georgesleen/microcouple/3d-model/microcouple.step

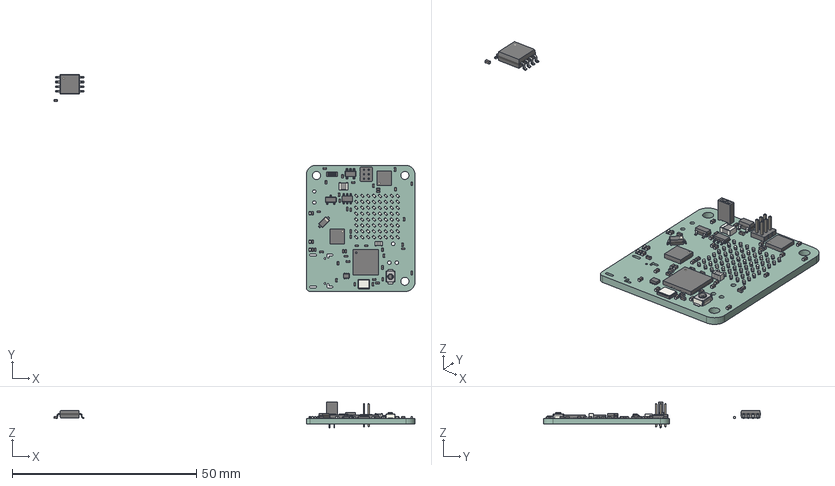
[picture p1: CAD file, 2025-11-13]
3d-model/microcouple.step
98.0 x 58.9 x 7.00 mm
LED_0402_1005Metric x 67
SW_SPST_B3U-1000P
C_0402_1005Metric x 43
L_1008_2520Metric
TSOT-23-6
SOT-23-5
SOT-23
QFN-32-1EP_4x4mm_P0.4mm_EP2.65x2.65mm
QFN-24-1EP_4x4mm_P0.5mm_EP2.6x2.6mm
QFN-56-1EP_7x7mm_P0.4mm_EP3.2x3.2mm
L_0805_2012Metric
PinHeader_2x03_P1.27mm_Vertical
SOIC-8_5.3x5.3mm_P1.27mm
SOT-666
PinSocket_2x01_P1.27mm_Vertical
Crystal_SMD_3225-4Pin_3.2x2.5mm
D_SOD-123
microcouple_PCB
