georgesleen/microcouple/drawings/microcouple-schematic-drawing.pdf/microcouple.pdf

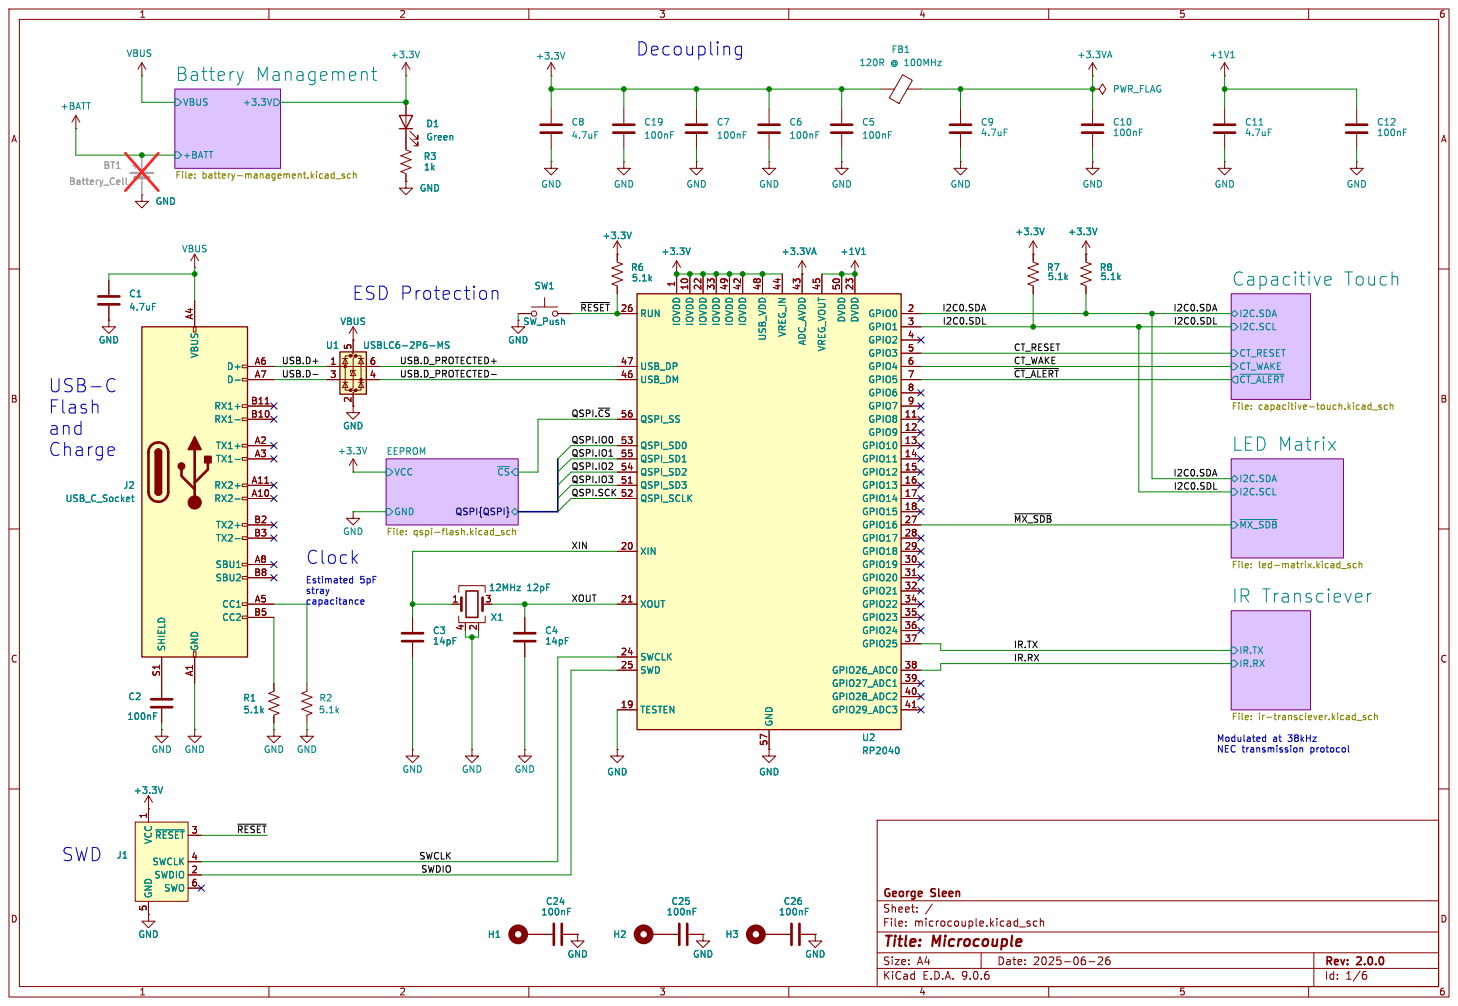
[picture p2: page 1]

+BATT Battery Management File: battery-management.kicad_sch

100nF GND
~{RESET} QSPI.IO0 QSPI.IO1 SWDIO

1 IOVDD 10 IOVDD 22 IOVDD 33 IOVDD 49 IOVDD 42 USB_VDD 48 GND 57 VREG_IN 44 ADC_AVDD 43 VREG_VOUT 45 DVDD 50 DVDD 23 GPIO0 2 GPIO1 3 GPIO2 4 GPIO3 5 GPIO4 6 GPIO5 7 GPIO6 8 GPIO7 9 GPIO8 11 GPIO9 12 GPIO10 13 GPIO11 14 GPIO12 15 GPIO13 16 GPIO14 17 GPIO15 18 GPIO16 27 GPIO17 28 GPIO18 29 GPIO19 30 GPIO20 31 GPIO21 32 GPIO22 34 GPIO23 35 GPIO24 36 GPIO25 37 GPIO26_ADC0 38 GPIO27_ADC1 39 GPIO28_ADC2 40 GPIO29_ADC3 41 U2 RP2040

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

I2C0.SDL QSPI.IO3 QSPI.IO2 XOUT

IR.TX USB.D+ USB.D-

5 ~{RESET}3 SWCLK 4 SWDIO 2 SWO 6 GND

5 ~{RESET}3 SWCLK 4 SWDIO 2 SWO 6

File: microcouple.kicad_sch Sheet: / George Sleen

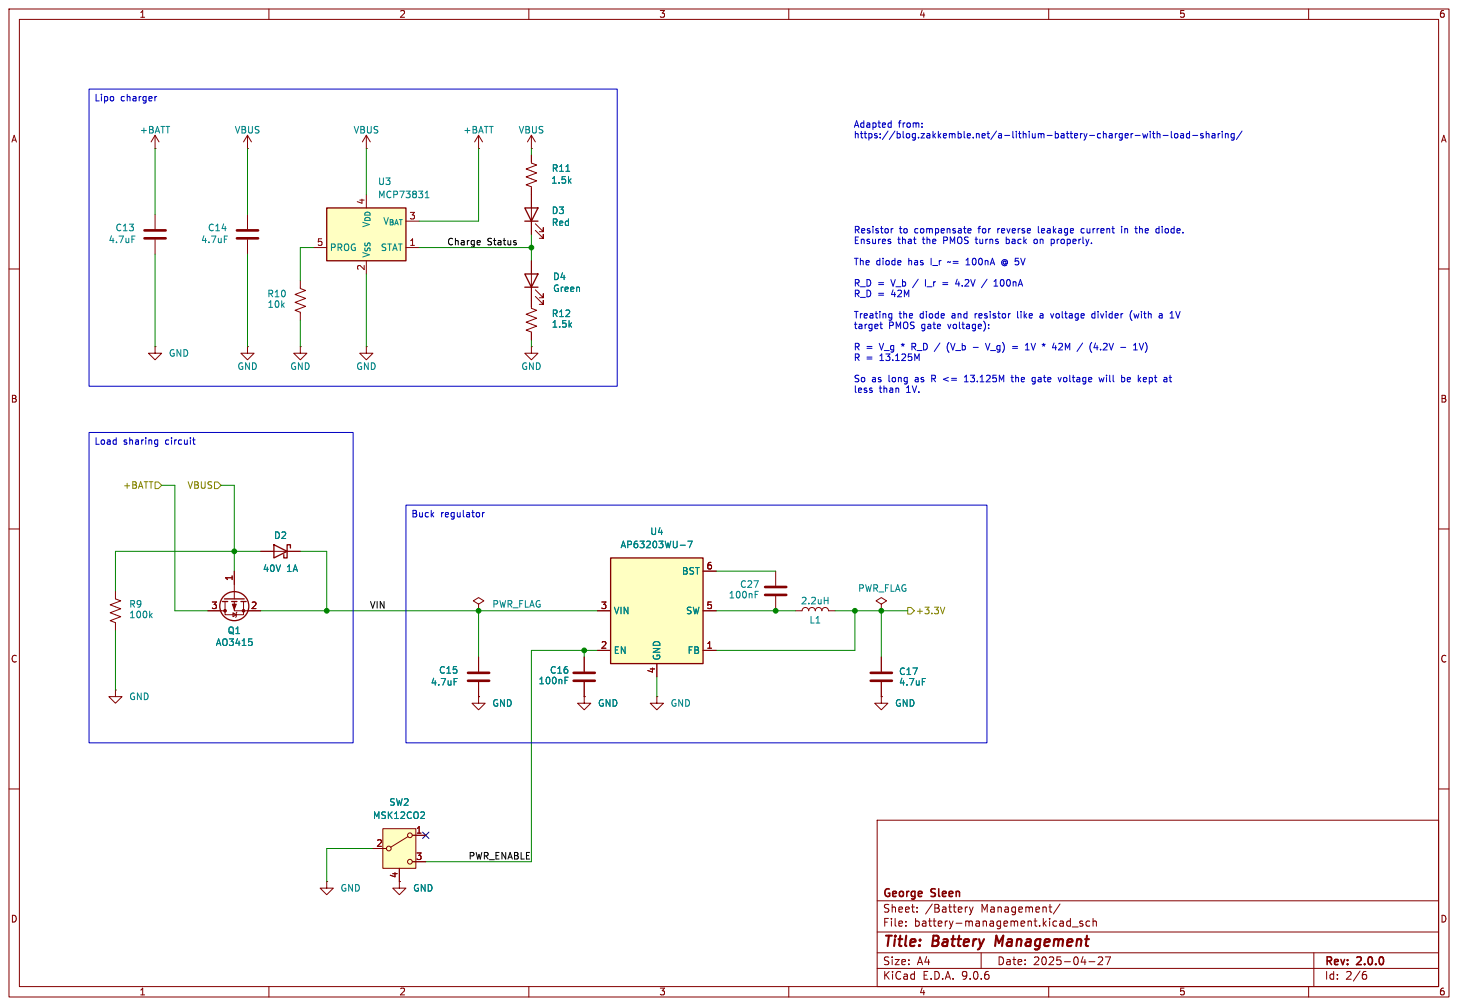
[picture p3: page 2]

Adapted from: https://blog.zakkemble.net/a-lithium-battery-charger-with-load-sharing/

target PMOS gate voltage): R = V_g * R_D / (V_b - V_g) = 1V * 42M / (4.2V - 1V) R = 13.125M
less than 1V. C17

So as long as R <= 13.125M the gate voltage will be kept at

4 BST 6 SW 5 FB 1 U4 AP63203WU-7 GND GND GND

4 BST 6 SW 5 FB 1 GND GND

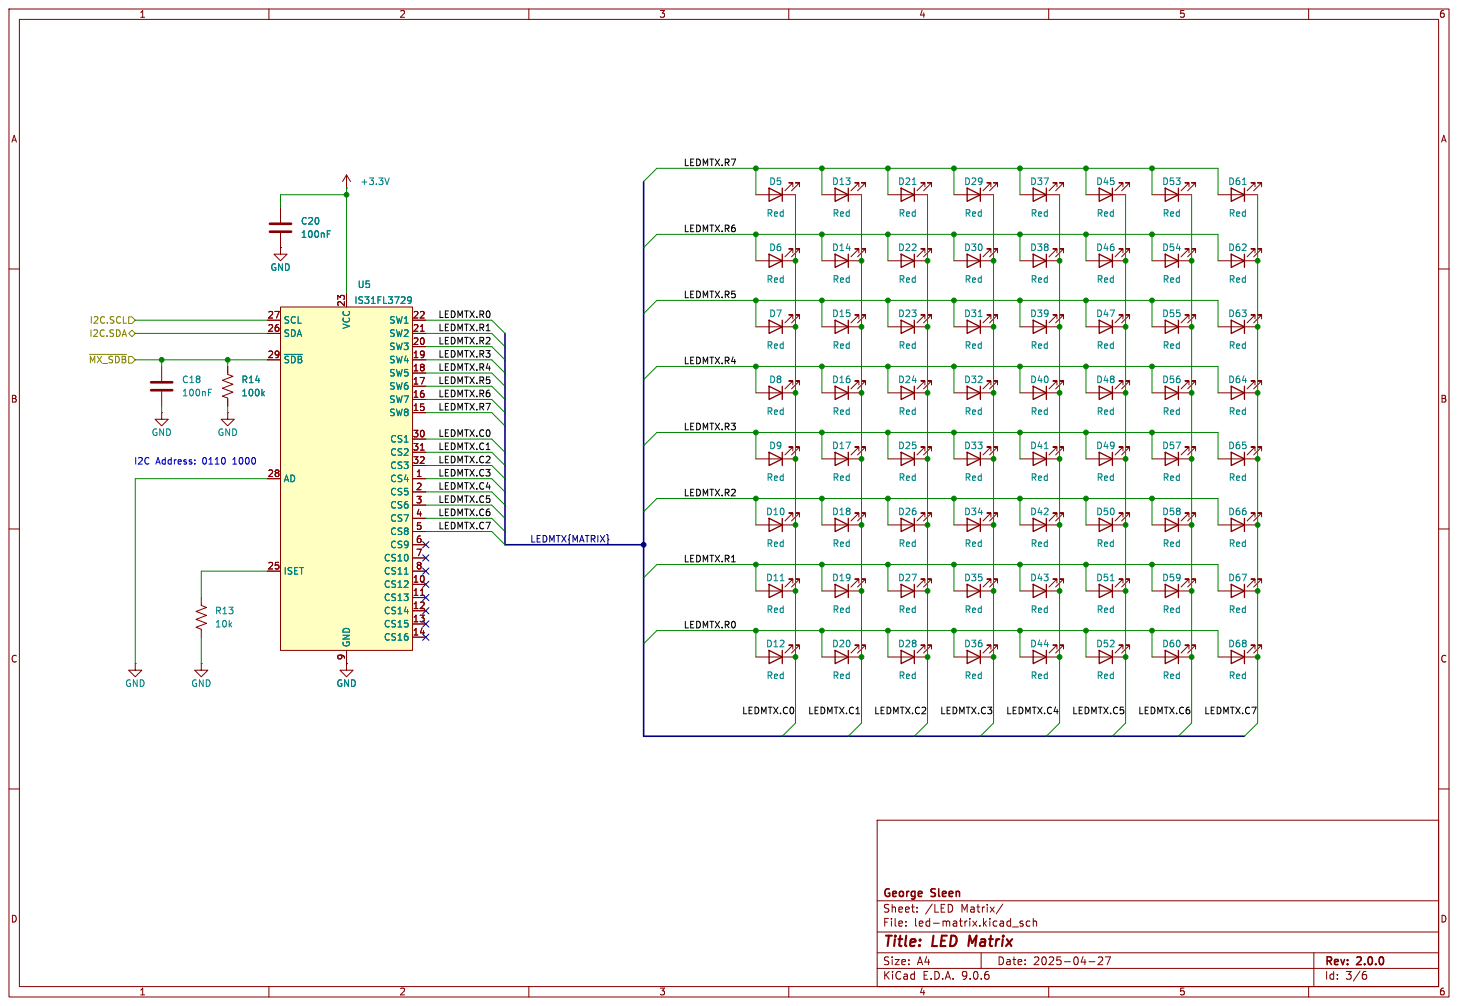
[picture p4: page 3]

D48 Red D21 Red D20 Red GND

Id: 3/6 Title: LED Matrix

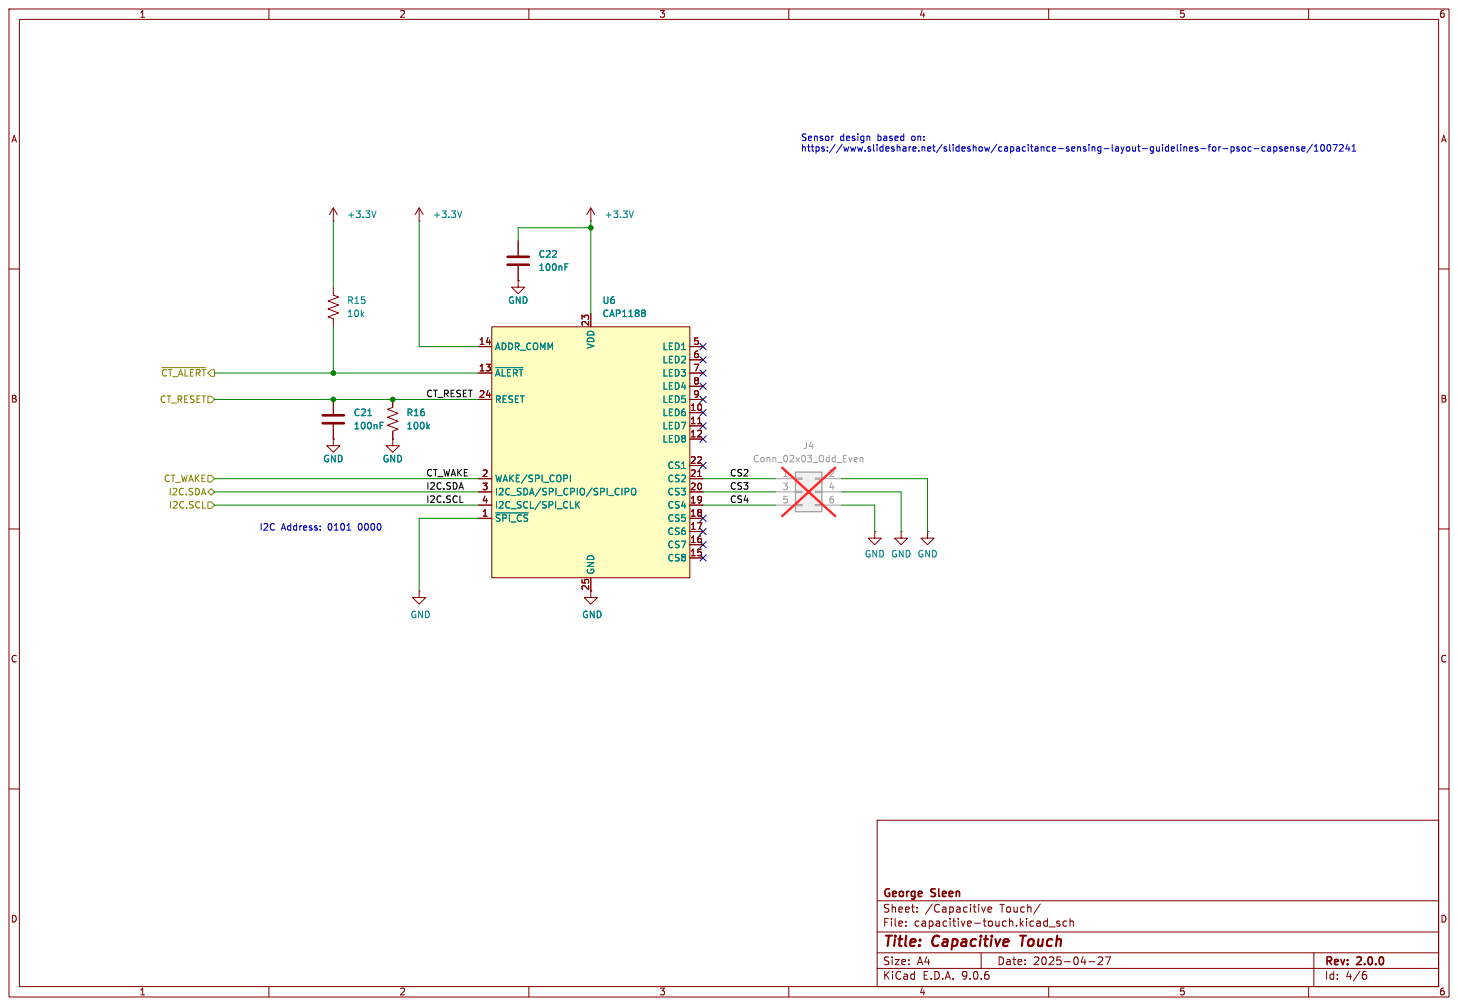
[picture p5: page 4]

Id: 4/6 Title: Capacitive Touch

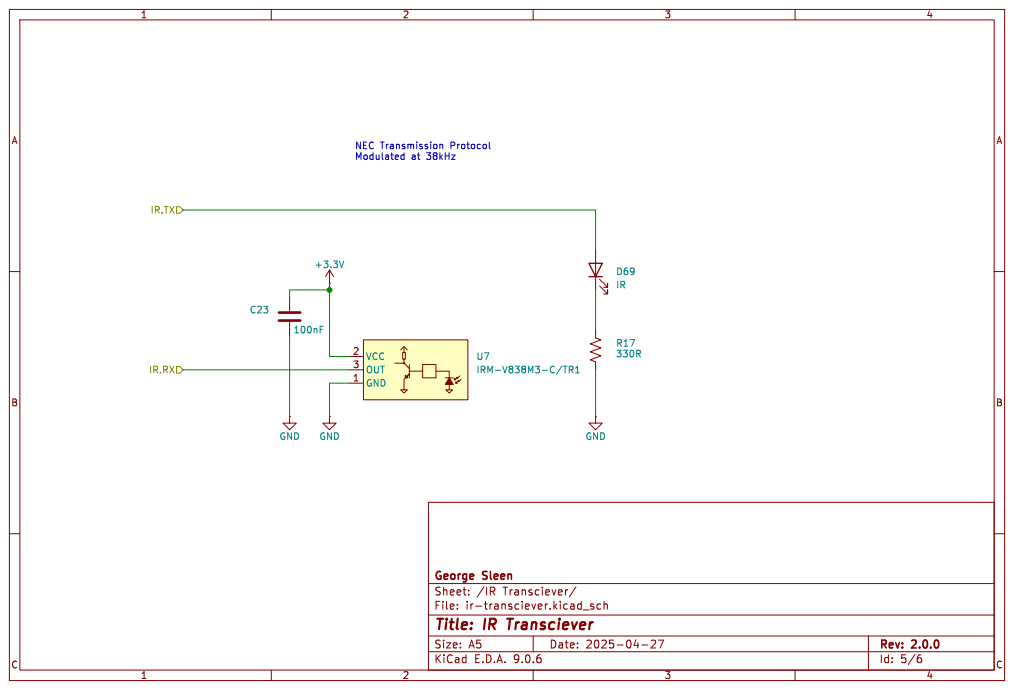
[picture p6: page 5]

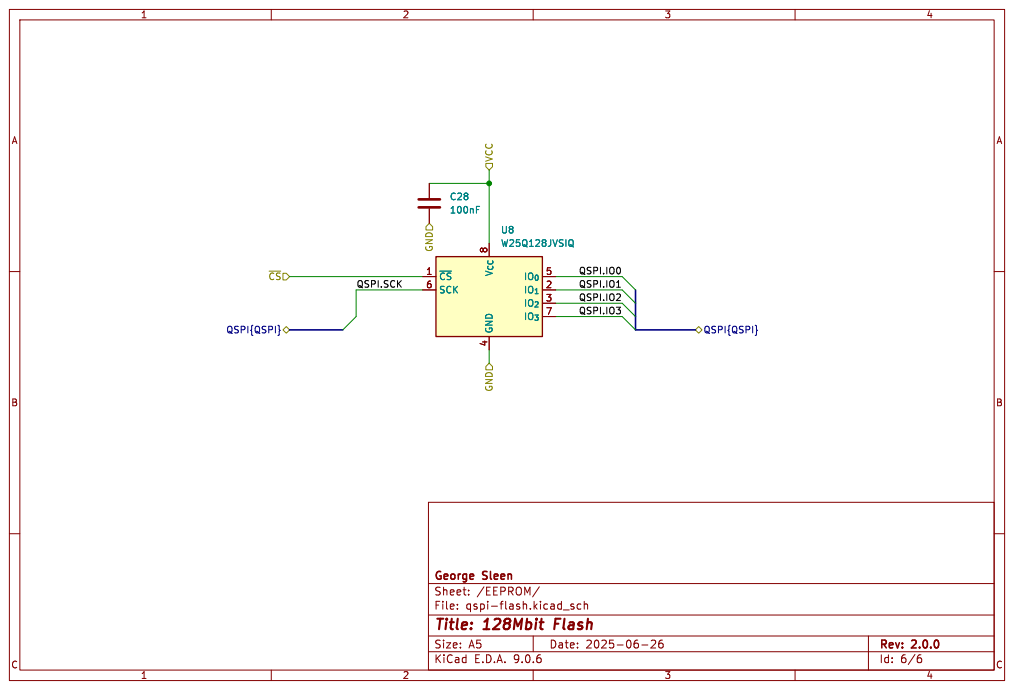
[picture p7: page 6]

File: qspi-flash.kicad_sch Sheet: /EEPROM/ George Sleen
