georgesleen/microcouple/drawings/microcouple-front-pcb-drawing.pdf/microcouple.pdf

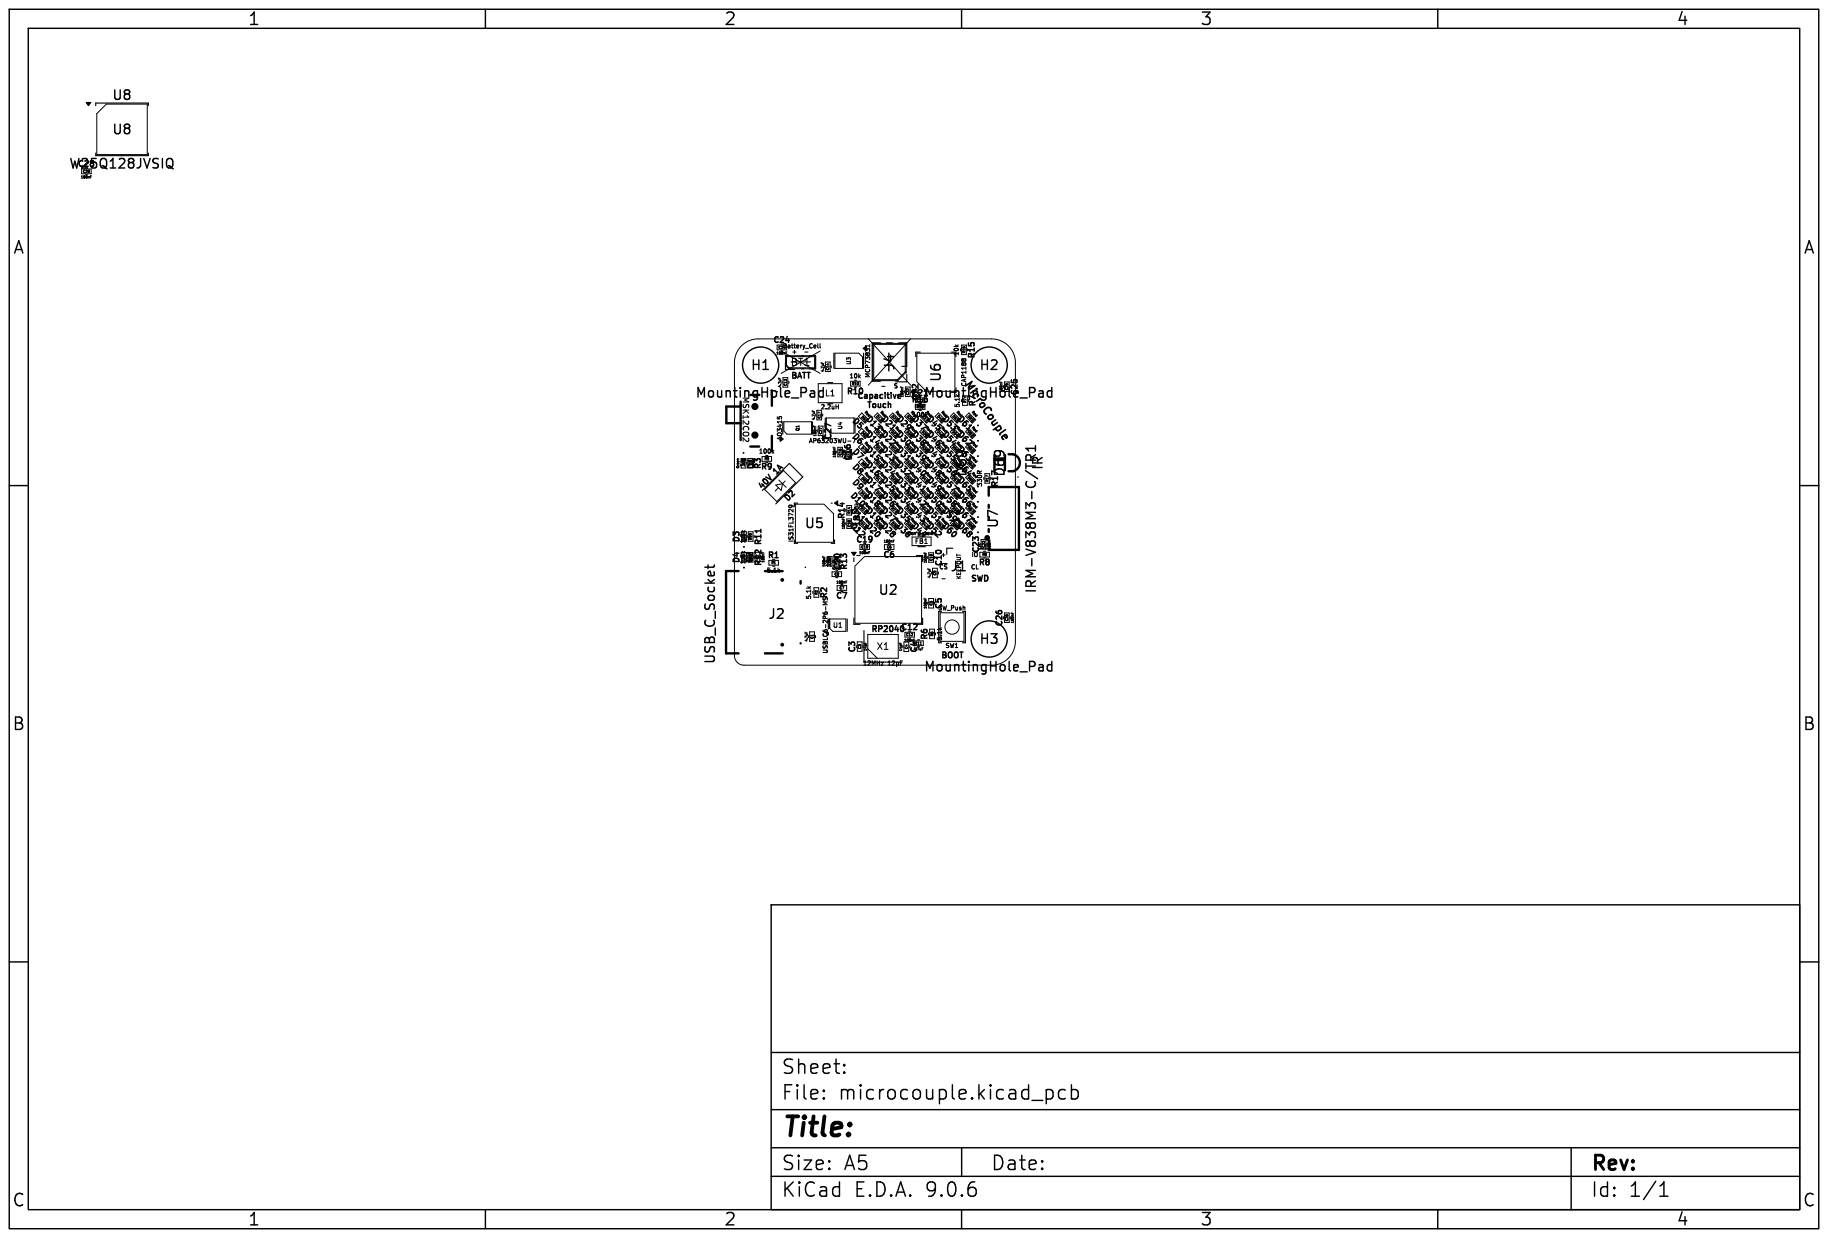
[picture p8: page 1]

Id: 1/1 Title: File: microcouple.kicad_pcb Sheet:
