georgesleen/microcouple/pcb/microcouple.kicad_pcb

## KiCad design pcb/microcouple.kicad_pcb (2025-06-26)

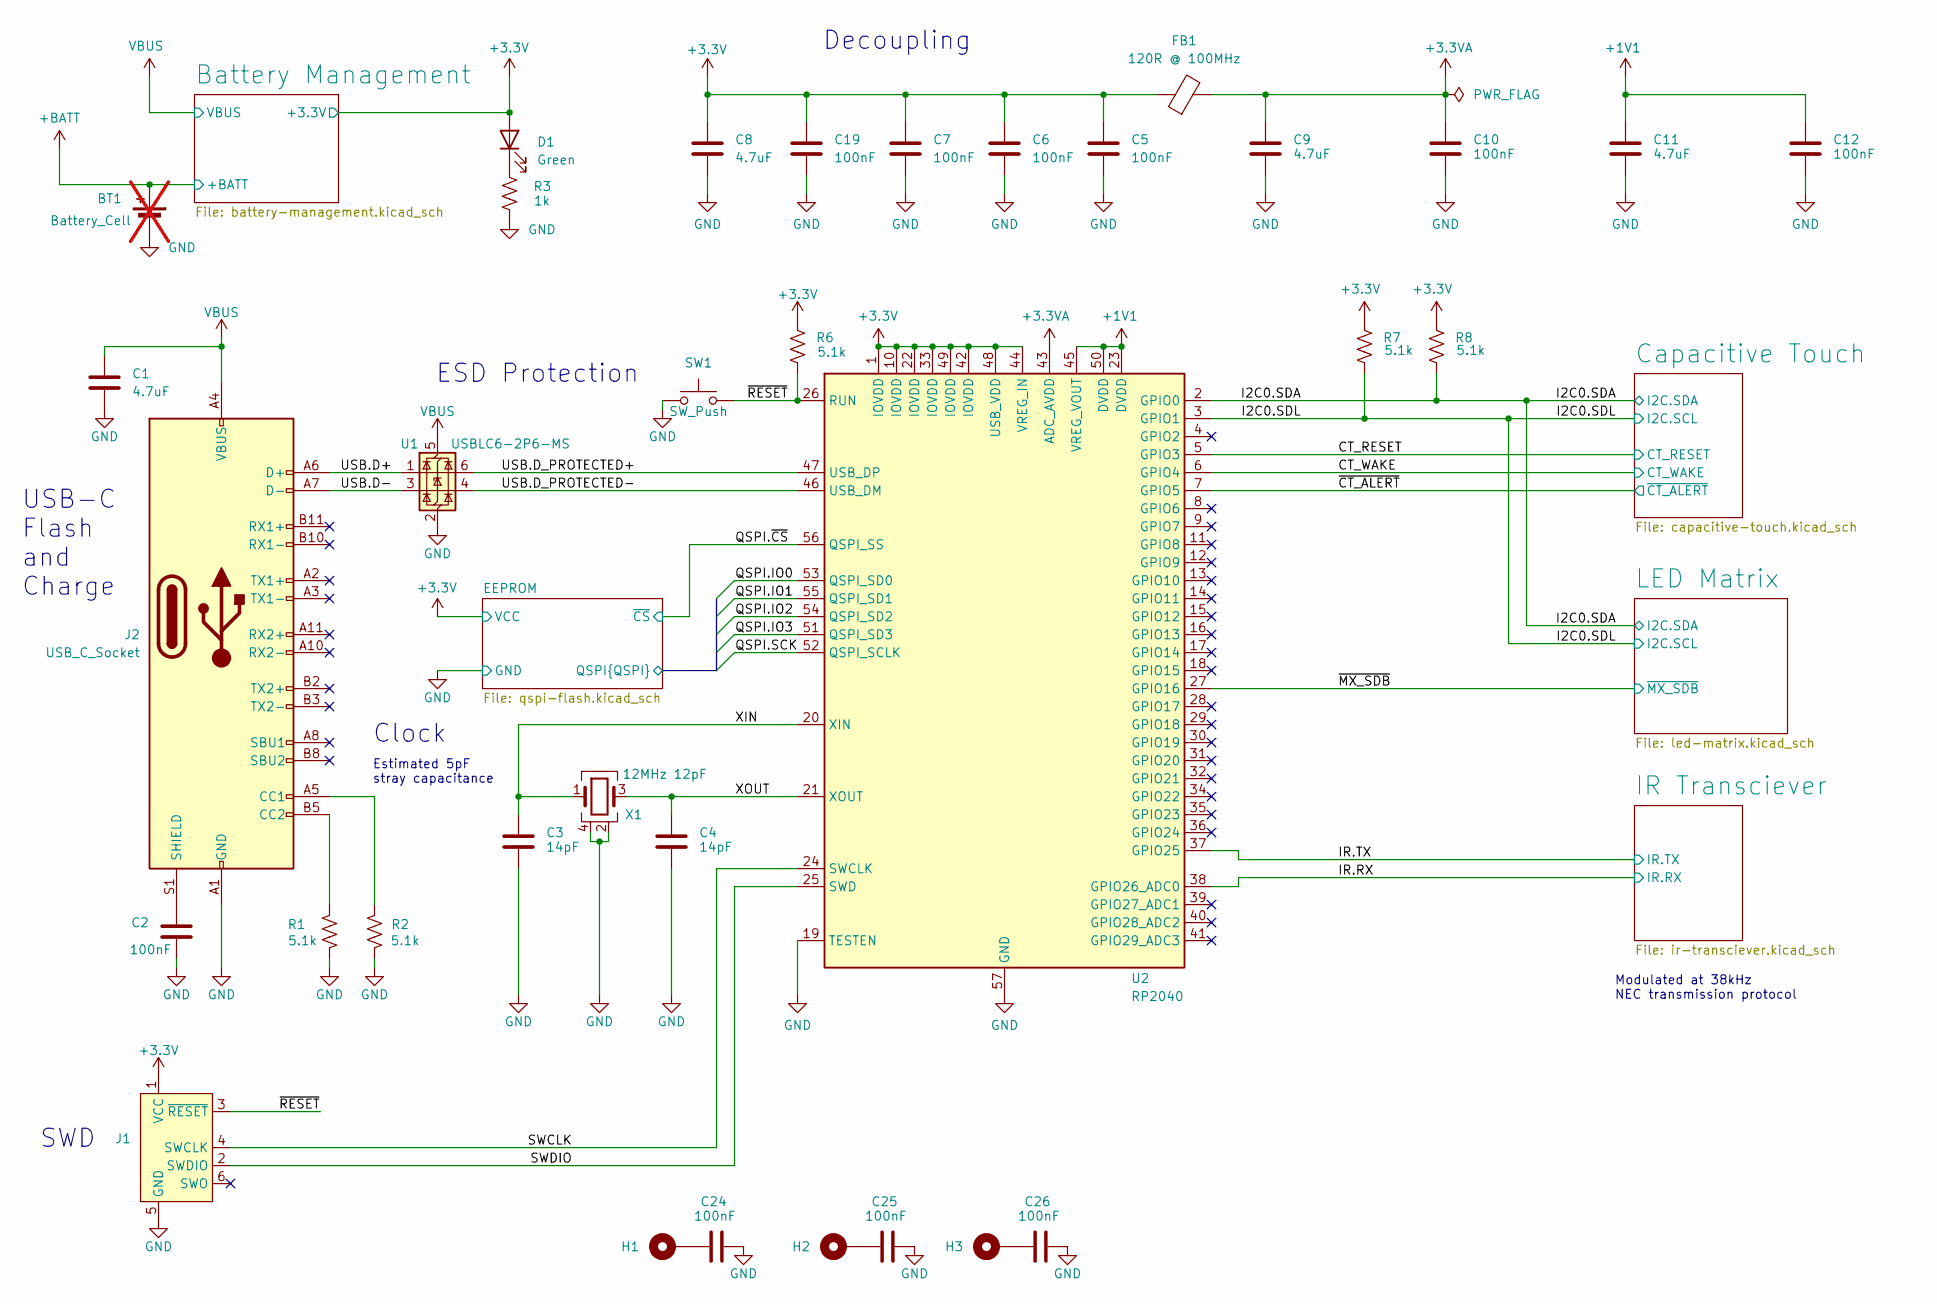
[picture p9: schematic microcouple.kicad_sch]

Parts:
BT1: Battery_Cell; PinSocket_2x01_P1.27mm_Vertical; not fitted
C1, C8, C9, C11: 4.7uF; C_0402_1005Metric; Mfr. Part # GRM155R60J475ME87D; LCSC ID C76996
C2, C5, C6, C7, C10, C12, C19, C24, C25, C26: 100nF; C_0402_1005Metric; Mfr. Part # TCC0402X5R104K160AT; LCSC ID C344189
C3, C4: 14pF; C_0402_1005Metric; Mfr. Part # 0402CG140J500NT; LCSC ID C3037644
D1: Green; LED_0402_1005Metric; Mfr. Part # XL-1005UGC; LCSC ID C965793
FB1: 120R @ 100MHz; L_0805_2012Metric; Mfr. Part # HCB2012KF-121T30; LCSC ID C356987
H1, H2, H3: MountingHole_Pad; MountingHole_2.2mm_M2_DIN965_Pad
J1: Conn_ARM_SWD_TagConnect_TC2030-NL; Tag-Connect_TC2030-IDC-NL_2x03_P1.27mm_Vertical
J2: USB_C_Socket; USB-C-SMD; Mfr. Part # TYPE-C 24P QT; LCSC ID C2681555
R1, R2, R6, R7, R8: 5.1k; R_0402_1005Metric; Mfr. Part # RC-02K512JT; LCSC ID C453708
R3: 1k; R_0402_1005Metric; Mfr. Part # FRC0402J102 TS; LCSC ID C2906899
SW1: SW_Push; SW_SPST_B3U-1000P; Mfr. Part # B3U-1000P; LCSC ID C231329
U1: USBLC6-2P6-MS; SOT-666; Mfr. Part # USBLC6-2P6; LCSC ID C2827693
U2: RP2040; QFN-56-1EP_7x7mm_P0.4mm_EP3.2x3.2mm; Mfr. Part # RP2040; LCSC ID C2040
X1: 12MHz 12pF; Crystal_SMD_3225-4Pin_3.2x2.5mm; Mfr. Part # TAXM12M4RFBCCT2T; LCSC ID C133337

Connections:
+1V1: C11.1, C12.1, U2.23 (DVDD), U2.45 (VREG_VOUT), U2.50 (DVDD)
+3.3V: C5.1, C6.1, C7.1, C8.1, C19.1, D1.2 (A), FB1.1, J1.1 (VCC), R6.1, R7.1, R8.1, U2.1 (IOVDD), U2.10 (IOVDD), U2.22 (IOVDD), U2.33 (IOVDD), U2.42 (IOVDD), U2.44 (VREG_IN), U2.48 (USB_VDD), U2.49 (IOVDD); also elsewhere on the board
+3.3VA: C9.1, C10.1, FB1.2, U2.43 (ADC_AVDD)
+BATT: BT1.1 (+); also elsewhere on the board
/CT_RESET: U2.5 (GPIO3); also elsewhere on the board
/CT_WAKE: U2.6 (GPIO4); also elsewhere on the board
/EEPROM/QSPI.IO0: U2.53 (QSPI_SD0); also elsewhere on the board
/EEPROM/QSPI.IO1: U2.55 (QSPI_SD1); also elsewhere on the board
/EEPROM/QSPI.IO2: U2.54 (QSPI_SD2); also elsewhere on the board
/EEPROM/QSPI.IO3: U2.51 (QSPI_SD3); also elsewhere on the board
/EEPROM/QSPI.SCK: U2.52 (QSPI_SCLK); also elsewhere on the board
/I2C0.SDA: R8.2, U2.2 (GPIO0); also elsewhere on the board
/I2C0.SDL: R7.2, U2.3 (GPIO1); also elsewhere on the board
/IR.RX: U2.38 (GPIO26_ADC0); also elsewhere on the board
/IR.TX: U2.37 (GPIO25); also elsewhere on the board
/QSPI.~CS: U2.56 (QSPI_SS); also elsewhere on the board
/SWCLK: J1.4 (SWCLK), U2.24 (SWCLK)
/SWDIO: J1.2 (SWDIO), U2.25 (SWD)
/USB.D+: J2.A6 (D+), J2.B6 (D+), U1.1 (I/O1)
/USB.D-: J2.A7 (D-), J2.B7 (D-), U1.3 (I/O2)
/USB.D_PROTECTED+: U1.6 (I/O1), U2.47 (USB_DP)
/USB.D_PROTECTED-: U1.4 (I/O2), U2.46 (USB_DM)
/XIN: C3.1, U2.20 (XIN), X1.1
/XOUT: C4.1, U2.21 (XOUT), X1.3
/~CT_ALERT: U2.7 (GPIO5); also elsewhere on the board
/~MX_SDB: U2.27 (GPIO16); also elsewhere on the board
/~RESET: J1.3 (~RESET), R6.2, SW1.2, U2.26 (RUN)
GND: BT1.2 (-), C1.2, C2.2, C3.2, C4.2, C5.2, C6.2, C7.2, C8.2, C9.2, C10.2, C11.2, C12.2, C19.2, C24.2, C25.2, C26.2, J1.5 (GND), J2.A1 (GND), J2.A12 (GND), J2.B1 (GND), J2.B12 (GND), R1.2, R2.1, R3.2, SW1.1, U1.2 (GND), U2.19 (TESTEN), U2.57 (GND), X1.2, X1.4; also elsewhere on the board
unnamed: C24.1, H1.1
unnamed: C25.1, H2.1
unnamed: C26.1, H3.1
unnamed: D1.1 (K), R3.1
unnamed: J2.A5 (CC1), R2.2
unnamed: J2.B5 (CC2), R1.1
unnamed: C2.1, J2.S1 (SHIELD)
VBUS: C1.1, J2.A4 (VBUS), J2.A9 (VBUS), J2.B4 (VBUS), J2.B9 (VBUS), U1.5 (VBUS); also elsewhere on the board

Notes on the sheet:
Decoupling
Estimated 5pF stray capacitance
USB-C Flash and Charge
Clock
SWD
Modulated at 38kHz NEC transmission protocol
ESD Protection

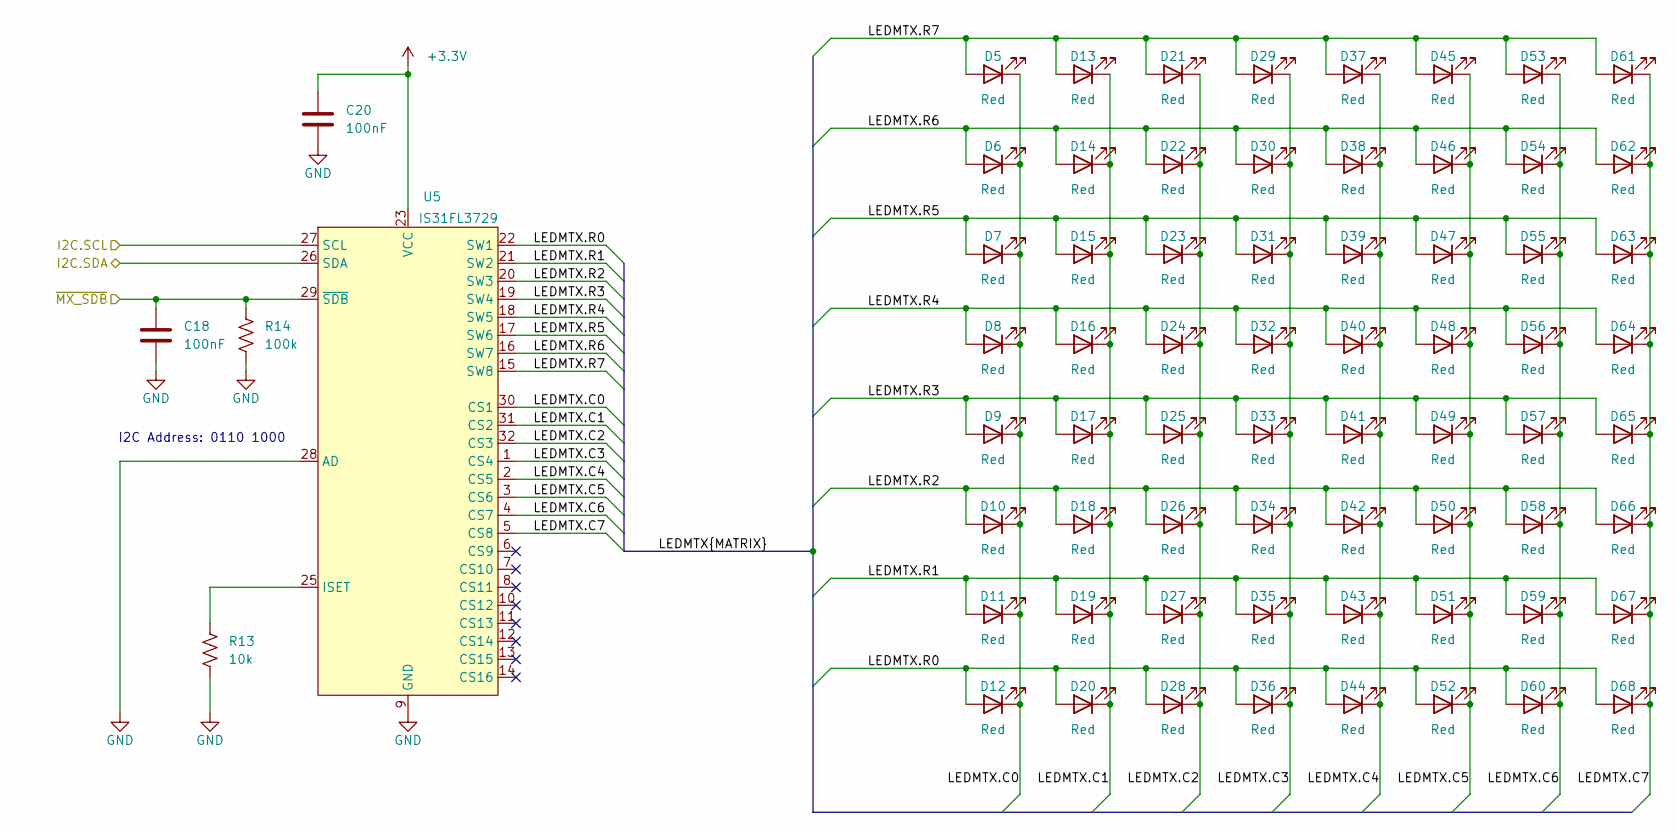
[picture p10: schematic led-matrix.kicad_sch, LED Matrix]

Parts:
C18, C20: 100nF; C_0402_1005Metric; Mfr. Part # TCC0402X5R104K160AT; LCSC ID C344189
D5, D6, D7, D8, D9, D10, D11, D12, D13, D14, D15, D16, D17, D18, D19, D20, D21, D22, D23, D24, D25, D26, D27, D28, D29, D30, D31, D32, D33, D34, D35, D36, D37, D38, D39, D40, D41, D42, D43, D44, D45, D46, D47, D48, D49, D50, D51, D52, D53, D54, D55, D56, D57, D58, D59, D60, D61, D62, D63, D64, D65, D66, D67, D68: Red; LED_0402_1005Metric; Mfr. Part # XL-1005SURC; LCSC ID C965790
R13: 10k; R_0402_1005Metric; Mfr. Part # RTT02103JTH; LCSC ID C102759
R14: 100k; R_0402_1005Metric; Mfr. Part # SCR0402J100K; LCSC ID C3017514
U5: IS31FL3729; QFN-32-1EP_4x4mm_P0.4mm_EP2.65x2.65mm; Mfr. Part # IS31FL3729-QFLS4-TR; LCSC ID C2940549

Connections:
+3.3V: C20.1, U5.23 (VCC); also elsewhere on the board
/I2C0.SDA: U5.26 (SDA); also elsewhere on the board
/I2C0.SDL: U5.27 (SCL); also elsewhere on the board
/LED Matrix/LEDMTX.C0: D5.1 (K), D6.1 (K), D7.1 (K), D8.1 (K), D9.1 (K), D10.1 (K), D11.1 (K), D12.1 (K), U5.30 (CS1)
/LED Matrix/LEDMTX.C1: D13.1 (K), D14.1 (K), D15.1 (K), D16.1 (K), D17.1 (K), D18.1 (K), D19.1 (K), D20.1 (K), U5.31 (CS2)
/LED Matrix/LEDMTX.C2: D21.1 (K), D22.1 (K), D23.1 (K), D24.1 (K), D25.1 (K), D26.1 (K), D27.1 (K), D28.1 (K), U5.32 (CS3)
/LED Matrix/LEDMTX.C3: D29.1 (K), D30.1 (K), D31.1 (K), D32.1 (K), D33.1 (K), D34.1 (K), D35.1 (K), D36.1 (K), U5.1 (CS4)
/LED Matrix/LEDMTX.C4: D37.1 (K), D38.1 (K), D39.1 (K), D40.1 (K), D41.1 (K), D42.1 (K), D43.1 (K), D44.1 (K), U5.2 (CS5)
/LED Matrix/LEDMTX.C5: D45.1 (K), D46.1 (K), D47.1 (K), D48.1 (K), D49.1 (K), D50.1 (K), D51.1 (K), D52.1 (K), U5.3 (CS6)
/LED Matrix/LEDMTX.C6: D53.1 (K), D54.1 (K), D55.1 (K), D56.1 (K), D57.1 (K), D58.1 (K), D59.1 (K), D60.1 (K), U5.4 (CS7)
/LED Matrix/LEDMTX.C7: D61.1 (K), D62.1 (K), D63.1 (K), D64.1 (K), D65.1 (K), D66.1 (K), D67.1 (K), D68.1 (K), U5.5 (CS8)
/LED Matrix/LEDMTX.R0: D12.2 (A), D20.2 (A), D28.2 (A), D36.2 (A), D44.2 (A), D52.2 (A), D60.2 (A), D68.2 (A), U5.22 (SW1)
/LED Matrix/LEDMTX.R1: D11.2 (A), D19.2 (A), D27.2 (A), D35.2 (A), D43.2 (A), D51.2 (A), D59.2 (A), D67.2 (A), U5.21 (SW2)
/LED Matrix/LEDMTX.R2: D10.2 (A), D18.2 (A), D26.2 (A), D34.2 (A), D42.2 (A), D50.2 (A), D58.2 (A), D66.2 (A), U5.20 (SW3)
/LED Matrix/LEDMTX.R3: D9.2 (A), D17.2 (A), D25.2 (A), D33.2 (A), D41.2 (A), D49.2 (A), D57.2 (A), D65.2 (A), U5.19 (SW4)
/LED Matrix/LEDMTX.R4: D8.2 (A), D16.2 (A), D24.2 (A), D32.2 (A), D40.2 (A), D48.2 (A), D56.2 (A), D64.2 (A), U5.18 (SW5)
/LED Matrix/LEDMTX.R5: D7.2 (A), D15.2 (A), D23.2 (A), D31.2 (A), D39.2 (A), D47.2 (A), D55.2 (A), D63.2 (A), U5.17 (SW6)
/LED Matrix/LEDMTX.R6: D6.2 (A), D14.2 (A), D22.2 (A), D30.2 (A), D38.2 (A), D46.2 (A), D54.2 (A), D62.2 (A), U5.16 (SW7)
/LED Matrix/LEDMTX.R7: D5.2 (A), D13.2 (A), D21.2 (A), D29.2 (A), D37.2 (A), D45.2 (A), D53.2 (A), D61.2 (A), U5.15 (SW8)
/~MX_SDB: C18.1, R14.1, U5.29 (~SDB); also elsewhere on the board
GND: C18.2, C20.2, R13.2, R14.2, U5.9 (GND), U5.24 (GND), U5.28 (AD), U5.33 (GND); also elsewhere on the board
unnamed: R13.1, U5.25 (ISET)

Notes on the sheet:
I2C Address: 0110 1000

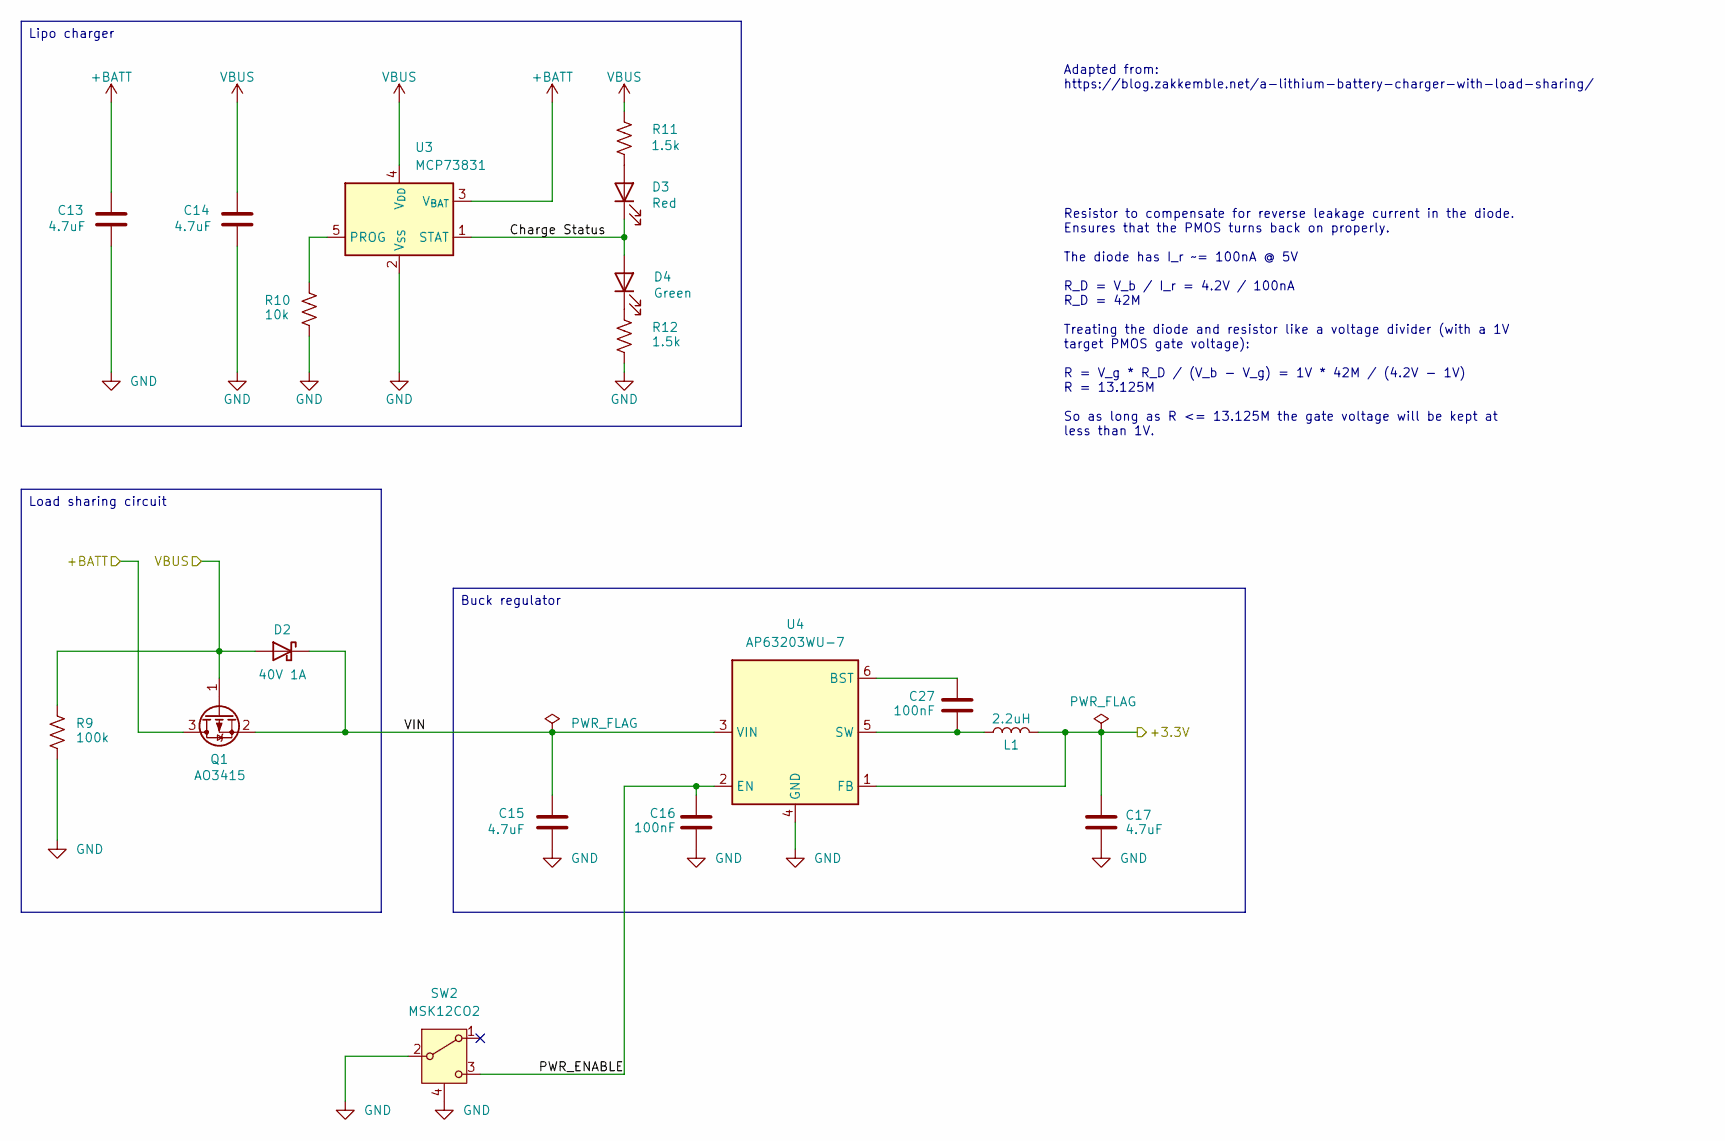
[picture p11: schematic battery-management.kicad_sch, Battery Management]

Parts:
C13, C14, C15, C17: 4.7uF; C_0402_1005Metric; Mfr. Part # GRM155R60J475ME87D; LCSC ID C76996
C16, C27: 100nF; C_0402_1005Metric; Mfr. Part # TCC0402X5R104K160AT; LCSC ID C344189
D2: 40V 1A; D_SOD-123; Mfr. Part # 1N5819W; LCSC ID C41431973
D3: Red; LED_0402_1005Metric; Mfr. Part # XL-1005SURC; LCSC ID C965790
D4: Green; LED_0402_1005Metric; Mfr. Part # XL-1005UGC; LCSC ID C965793
L1: 2.2uH; L_1008_2520Metric; Mfr. Part # PNR252012-2R2M; LCSC ID C19634045
Q1: AO3415; SOT-23; Mfr. Part # AO3415; LCSC ID C840839
R9: 100k; R_0402_1005Metric; Mfr. Part # SCR0402J100K; LCSC ID C3017514
R10: 10k; R_0402_1005Metric; Mfr. Part # RTT02103JTH; LCSC ID C102759
R11, R12: 1.5k; R_0402_1005Metric; Mfr. Part # FRC0402J152TS; LCSC ID C2929900
SW2: MSK12CO2; Mfr. Part # MINI MSK12CO2; LCSC ID C2681570
U3: MCP73831; SOT-23-5; Mfr. Part # MCP73831T-2ACI/OT; LCSC ID C424093
U4: AP63203WU-7; TSOT-23-6; Mfr. Part # AP63203WU-7; LCSC ID C780769

Connections:
+3.3V: C17.1, L1.2, U4.1 (FB); also elsewhere on the board
+BATT: C13.1, Q1.3 (D), U3.3 (V_{BAT}); also elsewhere on the board
/Battery Management/Charge Status: D3.1 (K), D4.2 (A), U3.1 (STAT)
/Battery Management/PWR_ENABLE: C16.1, SW2.3 (C), U4.2 (EN)
/Battery Management/VIN: C15.1, D2.1 (K), Q1.2 (S), U4.3 (VIN)
GND: C13.2, C14.2, C15.2, C16.2, C17.2, R9.2, R10.2, R12.1, SW2.2 (B), SW2.4 (Shield), U3.2 (V_{SS}), U4.4 (GND); also elsewhere on the board
unnamed: D3.2 (A), R11.1
unnamed: D4.1 (K), R12.2
unnamed: R10.1, U3.5 (PROG)
unnamed: C27.1, U4.6 (BST)
unnamed: C27.2, L1.1, U4.5 (SW)
VBUS: C14.1, D2.2 (A), Q1.1 (G), R9.1, R11.2, U3.4 (V_{DD}); also elsewhere on the board

Notes on the sheet:
Adapted from: https://blog.zakkemble.net/a-lithium-battery-charger-with-load-sharing/
Buck regulator
Load sharing circuit
Lipo charger
Resistor to compensate for reverse leakage current in the diode. Ensures that the PMOS turns back on properly. The diode has I_r ~= 100nA @ 5V R_D = V_b / I_r = 4.2V / 100nA R_D = 42M Treating the diode and resistor like a voltage divider (with a 1V target PMOS gate voltage): R = V_g * R_D / (V_b -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

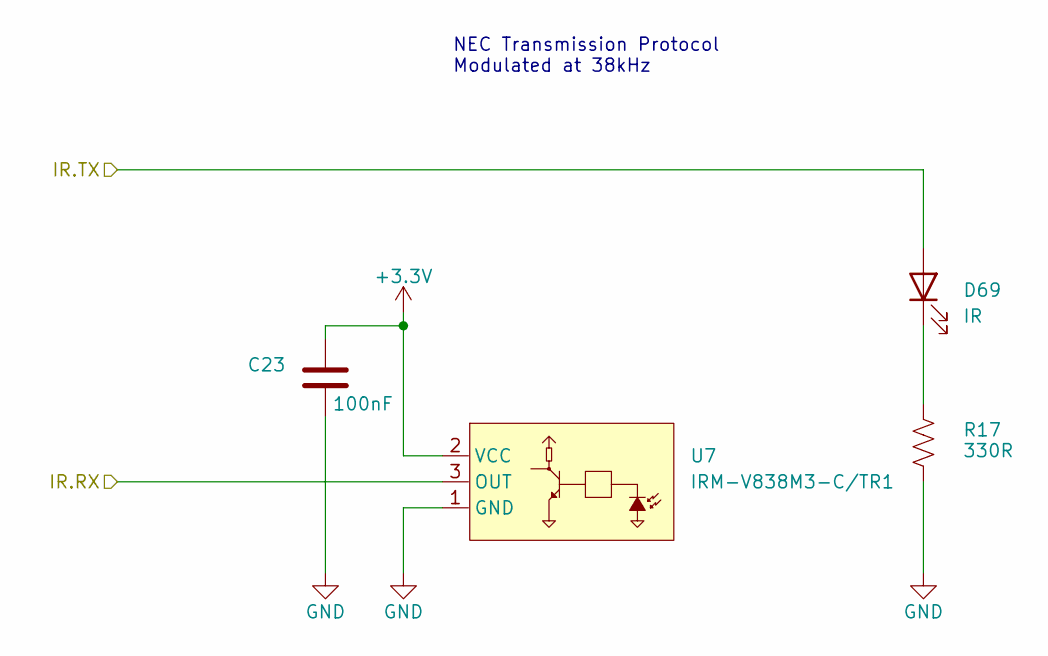
[picture p12: schematic ir-transciever.kicad_sch, IR Transciever]

Parts:
C23: 100nF; C_0402_1005Metric; Mfr. Part # TCC0402X5R104K160AT; LCSC ID C344189
D69: IR; LED_SMD_L3.0-W2.7-RD; Mfr. Part # IR26-61C/L302/TR8; LCSC ID C181893
R17: 330R; R_0402_1005Metric; Mfr. Part # FRC0402J331 TS; LCSC ID C2906929
U7: IRM-V838M3-C/TR1; IRM-V8__M3-C-TR1; Mfr. Part # IRM-V838M3-C/TR1; LCSC ID C3291489

Connections:
+3.3V: C23.1, U7.2 (VCC); also elsewhere on the board
/IR.RX: U7.3 (OUT); also elsewhere on the board
/IR.TX: D69.2 (A); also elsewhere on the board
GND: C23.2, R17.2, U7.1 (GND), U7.4 (GND); also elsewhere on the board
unnamed: D69.1 (K), R17.1

Notes on the sheet:
NEC Transmission Protocol Modulated at 38kHz

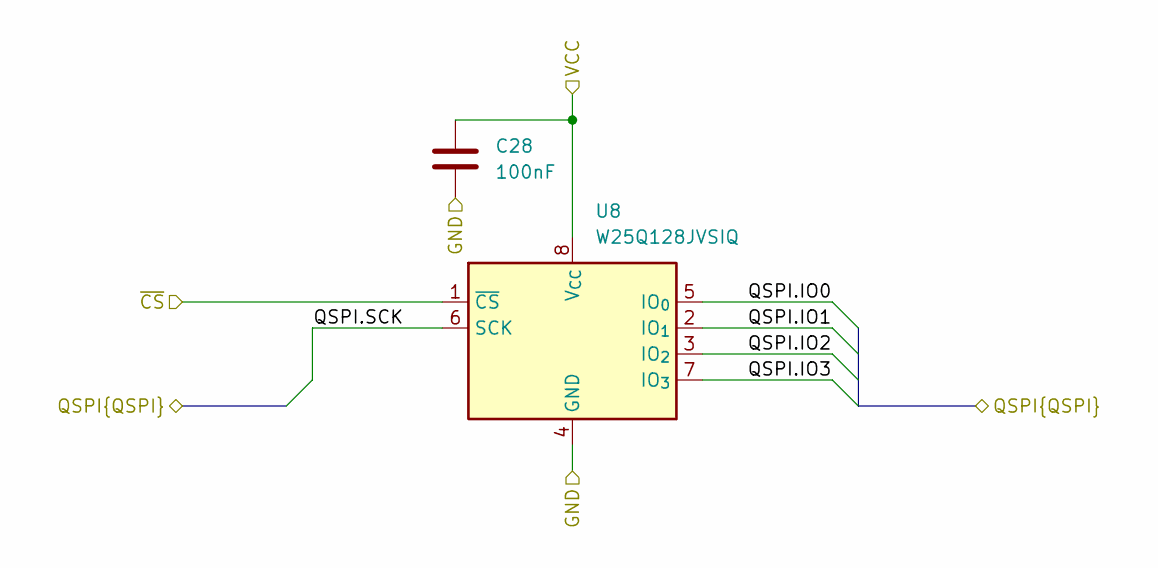
[picture p13: schematic qspi-flash.kicad_sch, 128Mbit Flash]

Parts:
C28: 100nF; C_0402_1005Metric; Mfr. Part # TCC0402X5R104K160AT; LCSC ID C344189
U8: W25Q128JVSIQ; SOIC-8_5.3x5.3mm_P1.27mm; Mfr. Part # W25Q128JVSIQ; LCSC ID C97521

Connections:
+3.3V: C28.1, U8.8 (V_{CC}); also elsewhere on the board
/EEPROM/QSPI.IO0: U8.5 (IO_{0}); also elsewhere on the board
/EEPROM/QSPI.IO1: U8.2 (IO_{1}); also elsewhere on the board
/EEPROM/QSPI.IO2: U8.3 (IO_{2}); also elsewhere on the board
/EEPROM/QSPI.IO3: U8.7 (IO_{3}); also elsewhere on the board
/EEPROM/QSPI.SCK: U8.6 (SCK); also elsewhere on the board
/QSPI.~CS: U8.1 (~CS); also elsewhere on the board
GND: C28.2, U8.4 (GND); also elsewhere on the board

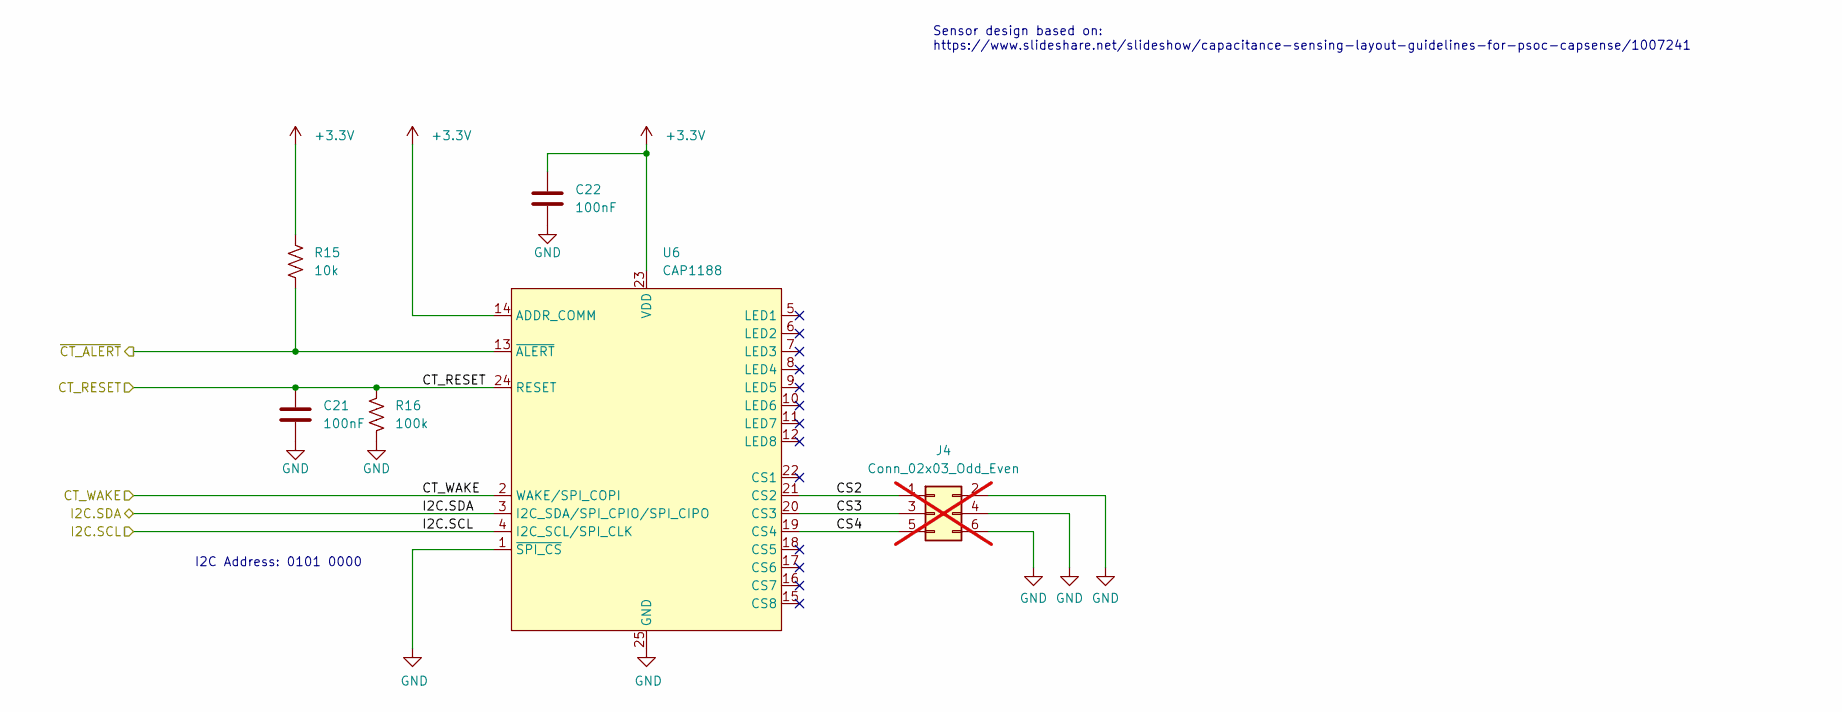
[picture p14: schematic capacitive-touch.kicad_sch, Capacitive Touch]

Parts:
C21, C22: 100nF; C_0402_1005Metric; Mfr. Part # TCC0402X5R104K160AT; LCSC ID C344189
J4: Conn_02x03_Odd_Even; PinHeader_2x03_P1.27mm_Vertical; not fitted
R15: 10k; R_0402_1005Metric; Mfr. Part # RTT02103JTH; LCSC ID C102759
R16: 100k; R_0402_1005Metric; Mfr. Part # SCR0402J100K; LCSC ID C3017514
U6: CAP1188; QFN-24-1EP_4x4mm_P0.5mm_EP2.5x2.5mm; Mfr. Part # CAP1188-1-CP-TR; LCSC ID C2652057

Connections:
+3.3V: C22.1, R15.1, U6.14 (ADDR_COMM), U6.23 (VDD); also elsewhere on the board
/CT_RESET: C21.1, R16.1, U6.24 (RESET); also elsewhere on the board
/CT_WAKE: U6.2 (WAKE/SPI_COPI); also elsewhere on the board
/Capacitive Touch/CS2: J4.1, U6.21 (CS2)
/Capacitive Touch/CS3: J4.3, U6.20 (CS3)
/Capacitive Touch/CS4: J4.5, U6.19 (CS4)
/I2C0.SDA: U6.3 (I2C_SDA/SPI_CPIO/SPI_CIPO); also elsewhere on the board
/I2C0.SDL: U6.4 (I2C_SCL/SPI_CLK); also elsewhere on the board
/~CT_ALERT: R15.2, U6.13 (~ALERT); also elsewhere on the board
GND: C21.2, C22.2, J4.2, J4.4, J4.6, R16.2, U6.1 (~SPI_CS), U6.25 (GND); also elsewhere on the board

Notes on the sheet:
I2C Address: 0101 0000
Sensor design based on: https://www.slideshare.net/slideshow/capacitance-sensing-layout-guidelines-for-psoc-capsense/1007241

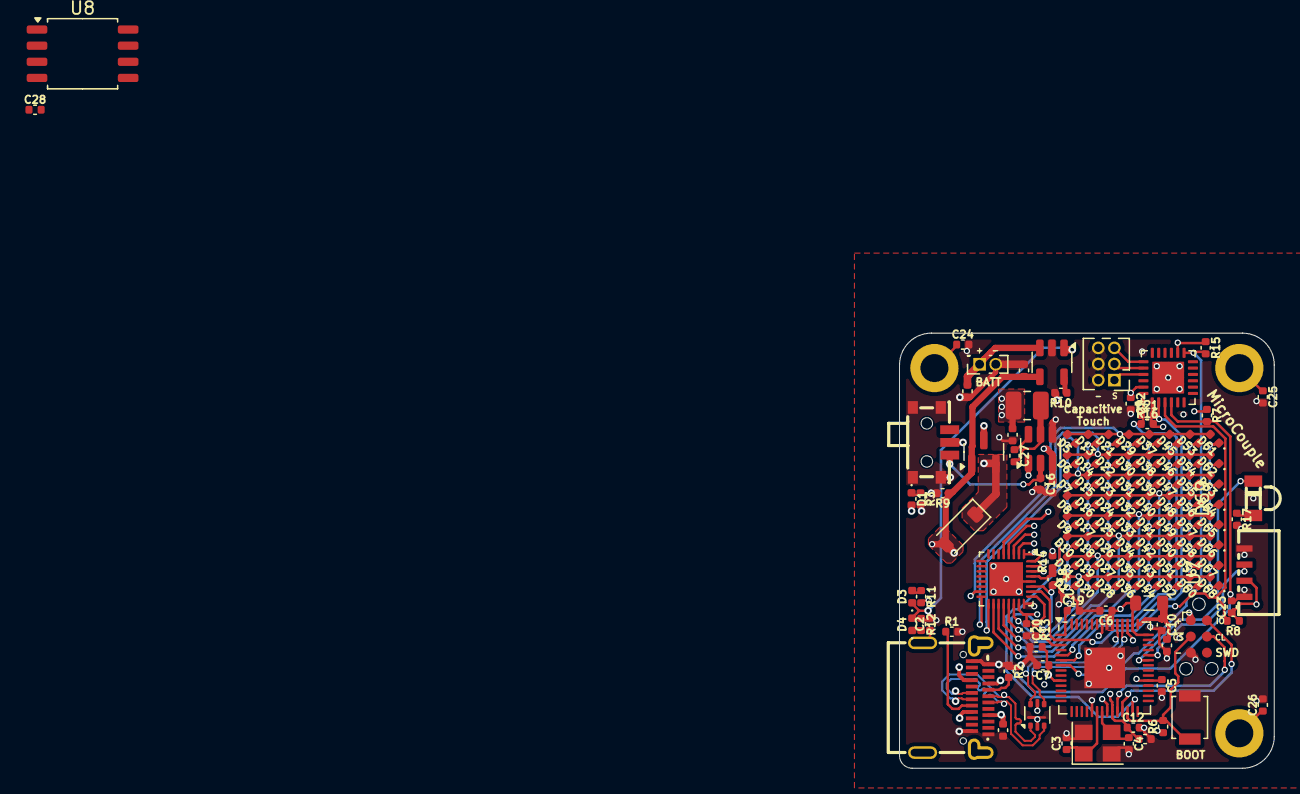
[picture p15: board microcouple.kicad_pcb from above]

Board: 4 copper layers, 29.5 x 34.2 mm, 133 parts (0 on the bottom side), 65 nets.
