georgesleen/microcouple/(commit log)

2025-02-02 Create functional blocks
    [battery-management.kicad_sch, ir-transceiver.kicad_sch, led-matrix.kicad_sch, microcontroller.kicad_sch, microcouple.kicad_pcb, microcouple.kicad_sch]
2025-02-02 Add decoupling caps on MCU
    [capacitive-touch.kicad_sch, microcontroller.kicad_sch, microcouple.kicad_sch]
2025-02-03 Sketch out IR transceiver
    [ir-transceiver.kicad_sch, led-matrix.kicad_sch, microcontroller.kicad_sch]
2025-02-03 Sketch out LED matrix
    [led-matrix.kicad_sch, microcouple.kicad_sch]
2025-02-03 First draft of LED matrix
    [ir-transceiver.kicad_sch, led-matrix.kicad_sch]
2025-03-04 Finalize battery management
    [battery-management.kicad_sch, capacitive-touch.kicad_sch, ir-transceiver.kicad_sch, led-matrix.kicad_sch, microcontroller.kicad_sch, microcouple.kicad_sch]
2025-03-04 Finish base MCU design
    [microcouple.kicad_sch]
2025-03-09 Preliminary Schematic
    [battery-management.kicad_sch, capacitive-touch.kicad_sch, ir-transciever.kicad_sch, led-matrix.kicad_sch, microcouple.kicad_pcb, microcouple.kicad_sch]
2025-03-21 Switch THT IR components to SMD ones
    [battery-management.kicad_sch, capacitive-touch.kicad_sch, ir-transciever.kicad_sch, led-matrix.kicad_sch, microcouple.kicad_pcb, microcouple.kicad_sch]
2025-03-21 Preliminary layout
    [battery-management.kicad_sch, capacitive-touch.kicad_sch, ir-transciever.kicad_sch, microcouple.kicad_pcb]
2025-03-27 Fix faulty USB-C CC pin connections
    [capacitive-touch.kicad_sch, microcouple.kicad_pcb, microcouple.kicad_sch]
2025-04-23 Draft layout
    [battery-management.kicad_sch, capacitive-touch.kicad_sch, ir-transciever.kicad_sch, led-matrix.kicad_sch, microcouple.kicad_pcb, microcouple.kicad_sch]
2025-04-25 Finish Silkscreen
    [battery-management.kicad_sch, capacitive-touch.kicad_sch, ir-transciever.kicad_sch, led-matrix.kicad_sch, microcouple.kicad_pcb, microcouple.kicad_sch]
2025-04-25 Finish layout
    [microcouple-B_Cu.gbr, microcouple-B_Mask.gbr, microcouple-B_Paste.gbr, microcouple-B_Silkscreen.gbr, microcouple-Edge_Cuts.gbr, microcouple-F_Cu.gbr, microcouple-F_Mask.gbr, microcouple-F_Paste.gbr]
2025-04-28 Update for JLCPCB
    [battery-management.kicad_sch, capacitive-touch.kicad_sch, ir-transciever.kicad_sch, led-matrix.kicad_sch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]
2025-04-28 Create JLC CPL and BOM
2025-04-28 Small fix to JLC BOM
    [capacitive-touch.kicad_sch, microcouple.kicad_sch]
2025-04-28 Change missing part on JLC
    [capacitive-touch.kicad_sch, microcouple.kicad_pcb, microcouple.kicad_sch]
2025-04-28 Change all components to 0402 if smaller
    [battery-management.kicad_sch, capacitive-touch.kicad_sch, ir-transciever.kicad_sch, led-matrix.kicad_sch, microcouple.kicad_pcb, microcouple.kicad_sch]
2025-05-15 Generate production outputs for 0201 components
    [microcouple_JLC_BOM.csv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]
2025-05-25 Refactor project structure
    [battery-management.kicad_sch, capacitive-touch.kicad_sch, ir-transceiver.kicad_sch, ir-transciever.kicad_sch, led-matrix.kicad_sch, microcontroller.kicad_sch, microcouple.kicad_pcb, microcouple.kicad_sch]
2025-06-26 Prepare schematic for revision 2.0.0
    [battery-management.kicad_sch, capacitive-touch.kicad_sch, ir-transciever.kicad_sch, led-matrix.kicad_sch, microcouple.kicad_pcb, microcouple.kicad_sch, qspi-flash.kicad_sch]
2025-06-26 Update BOM settings
    [microcouple_JLC_BOM.csv]
2025-11-13 Generate drawings
    [microcouple-bom.csv, microcouple.step]
